micho12345/E4/TP3/TP3_E4_G1.pdf

# TP Nº3 - ELECTRONICA IV: ´ Convertidor Trifasico ´

Bustelo, Nicolas´
61431

Venier Anache, Valentino
60097

Dalla Lasta, Pedro
59502

Resumen—El objetivo de este informe es el analisis del inverter ´ y la importancia de su proceso de diseno. ˜
Index Terms—Power Electronics, Circuit Analysis, Inverter, Switching Circuit, PWM Control, Inverter Testing and Measu-rement.
I. INTRODUCCION´
En este informe se detalla el diseno, implementaci ˜ | on y ´
analisis de un convertidor Inverter, detallado de forma ideal ´ en la Figura 1 con las siguientes caracter´ısticas:
mf | ma | F | MOS | Integrado
≤33 | ≤ 1.3 | 50Hz | IPD50R650CEAUMA1 | UCC27710DR

Se considera a la tension´ Vd como la tension rectificada de ´ la tension de l ´ ´ınea en Argentina (≈ 310V ± 20 %).

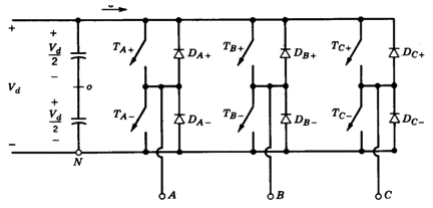
[picture p1: figure]

Figura 1: Inverter ideal generico. ´

II. DISENO˜

II-A. Simulacion´
Para hallar los mejores parametros para la modulaci ´ | on del ´
inverter, se recurrio a la plataforma de Matlab, utilizando la ´ biblioteca Simscape para armar mediante bloques en Simulink el modelo ideal propuesto en el Mohan, con ma = 0,8 y mf = 15.
Luego de corroborar el correcto funcionamiento utilizando una carga de R = 20Ω, L = 1mH identica para evitar el ´
desbalanceo, se procedio a investigar los valores ´ | optimos para ´
lograr la salida buscada. Buscando que la amplitud de la salida
pueda regularse de manera lineal, se opto por mantener ´ | ma
en 0.8 para operar en dicha zona (ma ≤ 1). Para eliminar la
mayor cantidad de armonicos posibles, ´ | mf deb´ıa ser impar
y multiplo de 3, por lo que finalmente se decidi ´ | o utilizar ´
mf = 33. Esto se puede explicar puesto que para valores muy grandes de mf , subarmonicos en cero y cercanos a cero pese a ´ su baja amplitud resultan en grandes corrientes que ser´ıan poco
deseables, y a valores pequenos para eliminar a los arm ˜ | onicos ´
pares mf debe ser impar. En adicion, si ´ | mf es multiplo de 3 ´
entonces los armonicos m ´ | as dominantes de la tensi ´ | on l ´ | ´ınea-a-
l´ınea se cancelan. Tambien se reduce la vibraci ´ | on en el motor, ´
as´ı como el calentamiento del mismo.

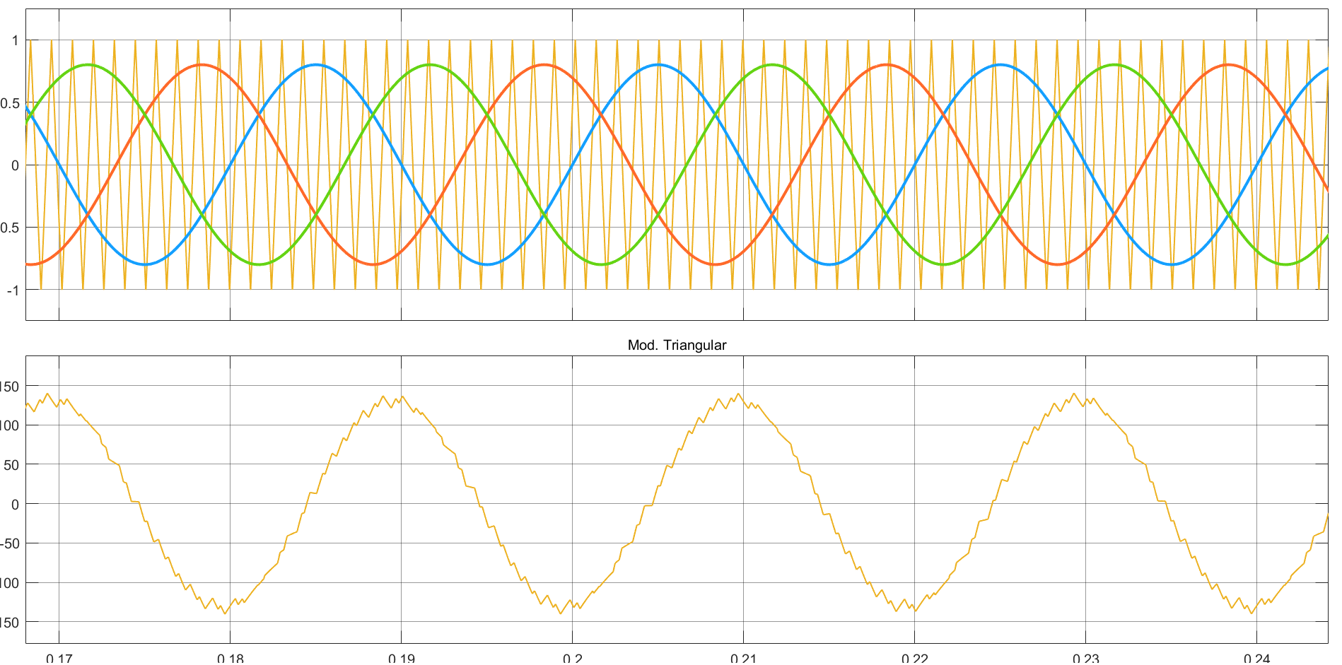
[picture p2: figure]

Figura 2: Salida de la simulacion, contrastada con las se ´ | nales ˜
del PWM

La tension l ´ ´ınea-a-l´ınea, anteriormente mencionado, puede describirse como:

VLL =

√
3
√
2
VˆAN = 0,612maVd = 152,327Vrms | (1)
En la simulacion puede apreciarse que ´ | VLL alcanza valores
cercanos a 138,8Vrms, lo cual es entendible puesto que la carga empleada al simular no es ideal. No obstante, como se observara m´ as adelante, los resultados arrojados son bastante ´ cercanos a lo visto al medir la placa.
Si se aumenta el valor de ma a un valor muy grande (por ejemplo 100) se podr´ıa apreciar otro tipo de modulacion: la ´
modulacion de onda cuadrada. En la misma cada switch est ´ | a´
prendido durante 180o
(un Duty del 50 %) por lo tanto, en cualquier instante, siempre hay tres llaves encendidas. En este tipo de modulacion, el ´ inverter no puede controlar la amplitud de la salida de la tension´ AC, por lo que se requiere que se
controle la tension de entrada ´ | Vd para controlar la misma.
Consecuentemente, la tension l ´ | ´ınea-a-l´ınea ahora se describe
como:

VLL =

√
√
2

π

Vd
2
= 0,78Vd = 242,679Vrms | (2)
Mientras que en la simulacion la tensi ´ | on resultante es ´
229,45Vrms. Si comparamos ambas salidas una junto a la
otra se puede ver como la modulaci ´ | on cuadrada tiene mayor ´
amplitud, a coste de una distorsion arm ´ | onica mucho mayor: ´

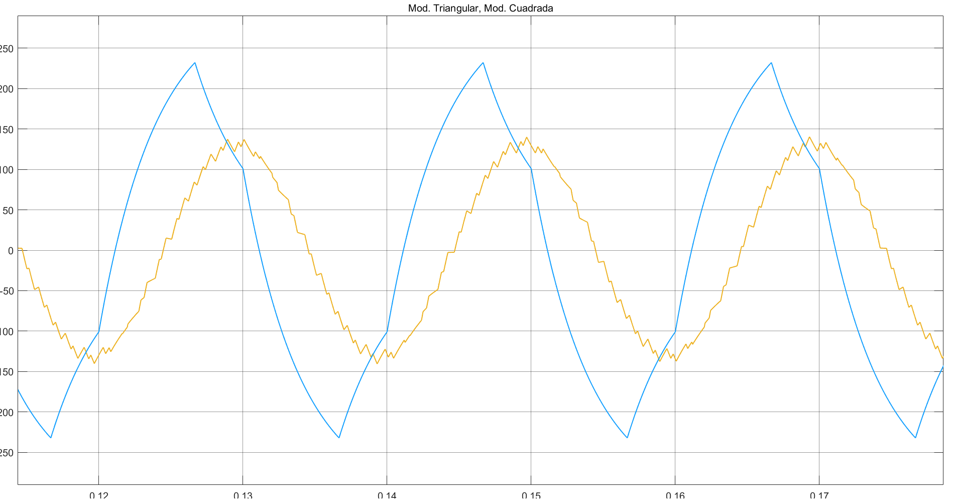
[picture p3: figure]

Figura 3: Comparacion entre ambos m ´ | etodos de modulaci ´ | on´

III. CONTROL DE DISPARO
El sistema de control de disparo de las ramas se basa
en la implementacion de una placa ´ | UPDuino v3.0 la cual
contiene un modulo ´ | FPGA.
La programacion se basa en tres m ´ | odulos principales de los ´
cuales se interconectan para lograr seis salidas.
El primer modulo ´ | TriangularWaves se encarga de generar
una senal triangular la cu ˜ | al tiene amplitud y frecuencia confi- ´
gurables ya que una de las funciones que debe poderse hacer
es cambiar los ´ındices de modulacion, tanto ´ | mf como ma.
Este bloque se basa en un contador de 12 bits signados que cuando llega a su maximo valor se decrementa y cuando llega ´ a su m´ınimo valor se incrementa. De esta forma y con un divisor de clock a la mitad del valor real (12MHz) se genera
una senal triangular de frecuencia ˜ | 1490Hz.
El segundo modulo ´ | ModulatingWaves es el mas importante ´
de los tres. Su funcion principal se basa en buscar datos en ´ una LUT establecida en memoria SRAM con funcionamiento de 1MHz. Son tres los punteros que recorren la tabla indicando
la posicion de cada valor correspondiente a las tres se ´ | nales ˜
de un sistema trifasico, es decir, cada puntero se encuentra ´ desfasado 120o
en representacion de una se ´ | nal real. ˜
En la LUT se encuentran 10000 muestras de medio ciclo de senoide en donde cada muestra es de 12 bits. Con este muestreo y con el modulo mencionado, se puede recrear una ´ senoidal completa de 20000 muestras ya que si se recorre la tabla de forma inversa y con el valor de la tabla negado, se obtiene el medio ciclo faltante. El primer puntero comienza en la posicion´ 0 con el valor de la tabla contando en forma ascendente, el segundo puntero comienza en la posicion´ 6666 con el valor de la tabla contando en forma ascendente, y el tercer puntero comienza con el valor de la tabla negado contando en forma descendente. Aqu´ı se obtienen los valores iniciales de tres senoides desfasadas 120o

Como no se pueden rescatar tres valores a la vez en un mismo ciclo de clock, se utiliza una maquina de estados en ´ la cual busca los valores de a uno para luego en el doceavo ´ ciclo ponerlo en la salida. Esto se puede hacer ya que como la salida cambia cada 1µs y el clock interno trabaja en menos tiempo, se utiliza ese tiempo para poder rescatar los datos. El tercer modulo ´ Comparator es simplemente un compa-rador que observa dos valores de 12 bits y dependiendo cual´ sea el valor, en la salida habra un ´ 1 o un 0. Si la entrada proveniente de la senoidal generada es mayor que la senal de ˜ la triangular, la salida sera un ´ 1, caso opuesto la salida sera´ 0. Como esta es la salida final de uno de los MOS de una rama,
este modulo tambi ´ | en tiene una salida extra que es exactamente ´
la opuesta a la salida original. Dado con esto incluido, ya
se obtienen las dos senales para una rama, una para el ˜ | MOS
superior y otra para el MOS inferior. Por lo tanto, habra tres ´ comparadores en total, lo cual generan las seis salidas para las ´ tres ramas correspondientes.
Una vez obtenidos los tres bloques, se designaron los pines de salida y se conectaron al PCB del inverter.

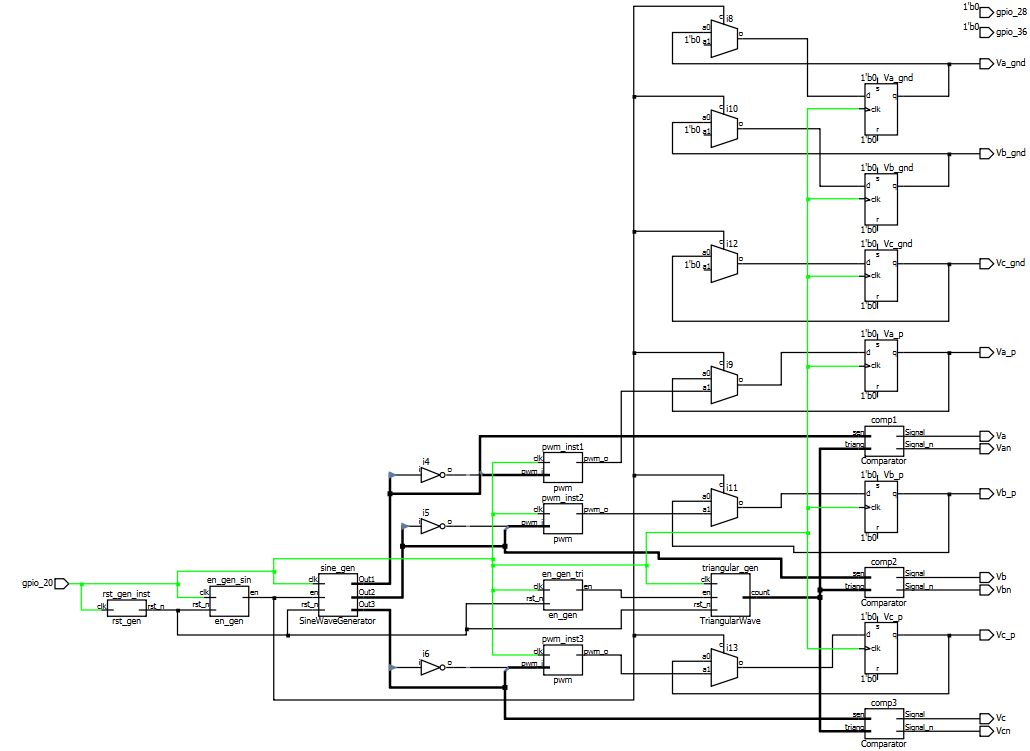
[picture p4: figure]

Figura 4: NetList de Programacion. ´

IV. IMPLEMENTACION´

IV-A. PCB
Concluidos el analisis te ´ | orico y las simulaciones, se proce- ´
dio a fabricar el ´ | PCB. En la Figura 16 del anexo se puede ver
el esquematico utilizado. ´

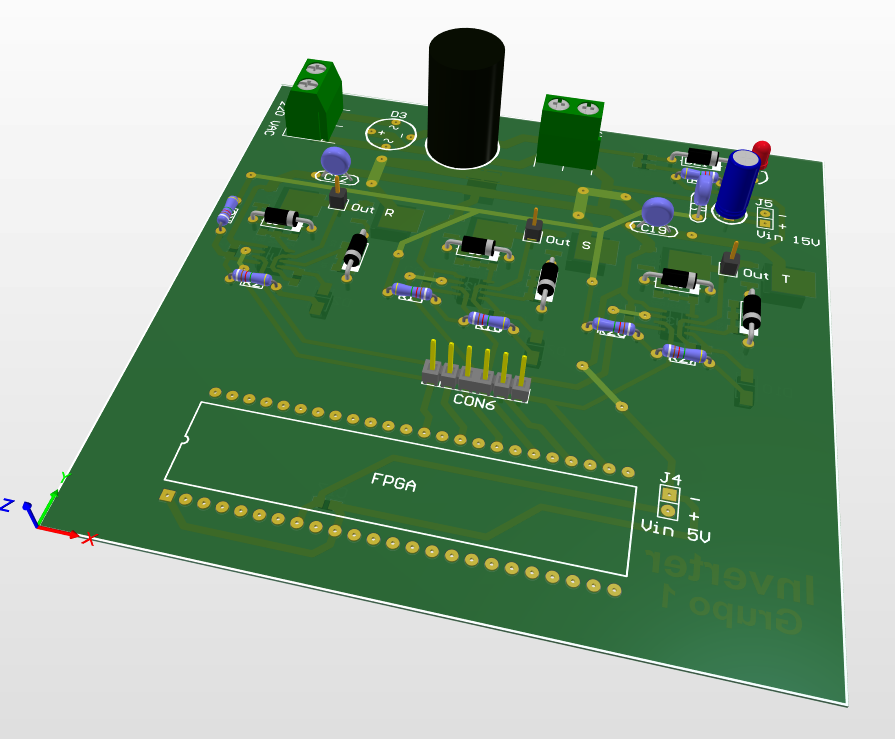
[picture p5: figure]

Figura 5: Modelo PCB en Altium.

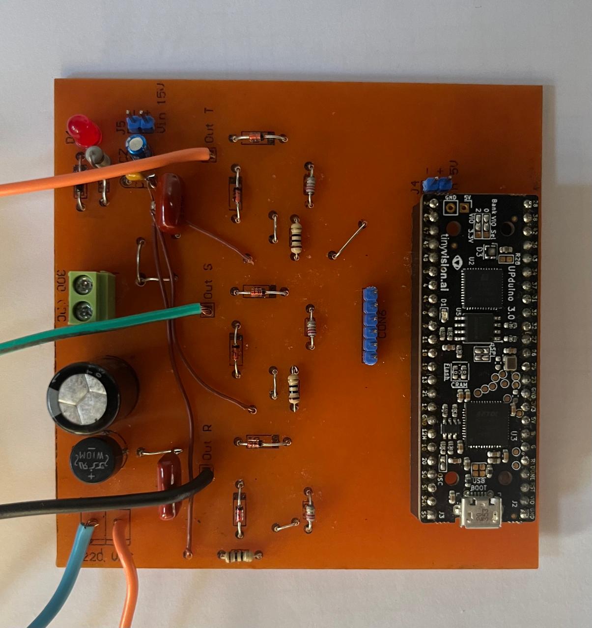
[picture p6: figure]

Figura 6: Placa vista superior.

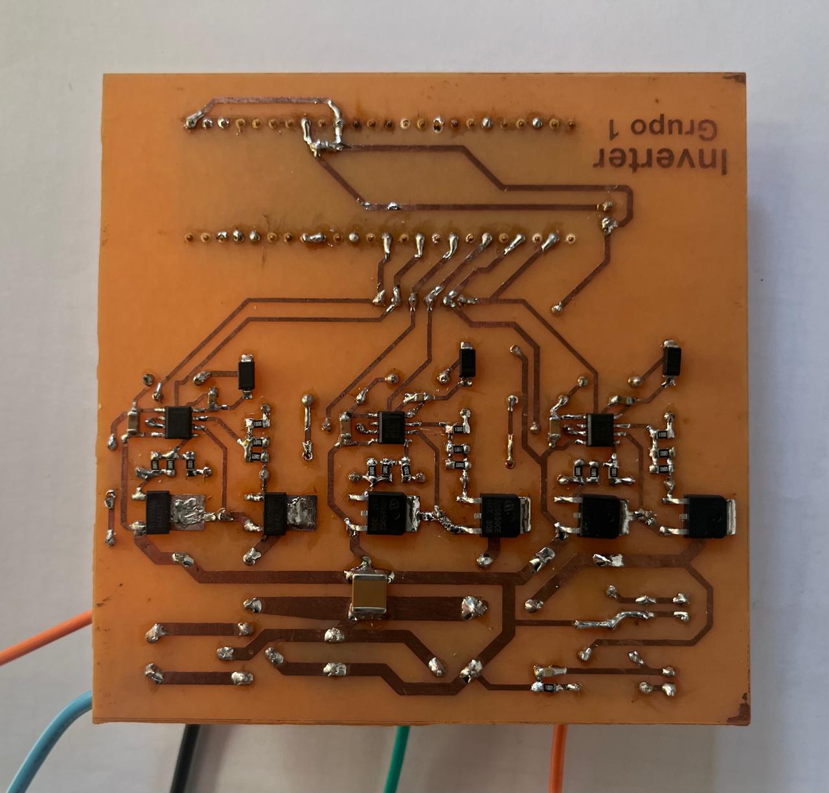
[picture p7: figure]

Figura 7: Placa vista inferior.

Para el analisis del ´ | layout, se tuvieron en cuenta los lazos
de corriente que existen en el apagado y el encendido del
transistor. Por esta razon, la configuraci ´ | on de los componentes ´
y de las pistas se tuvo que disenar detalladamente para prevenir ˜ corrientes inducidas no deseadas, evitando lazos de corrientes englobados. Tras numerosas iteraciones se logro obtener el layout deseado que se puede observar en la siguiente figura:

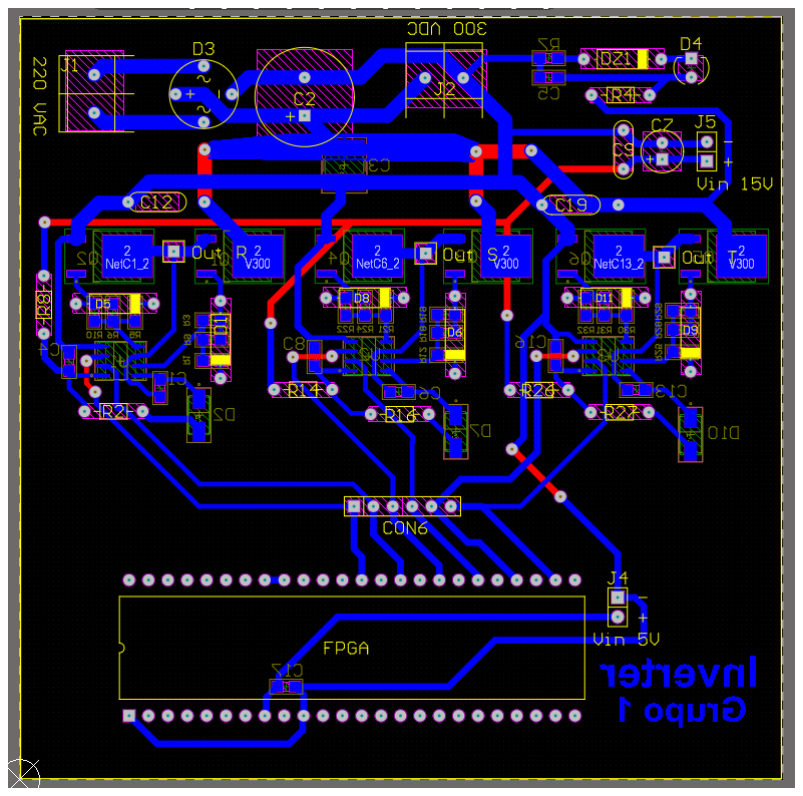
[picture p8: figure]

Figura 8: Layout del PCB

IV-B. Metodo de puesta en marcha ´
Para probar el circuito, se conecto la entrada del circuito ´ a un variac apagado y con salida m´ınima. Este a su vez esta´ conectado a un transformador de aislacion´ 1 : 1, que se conecta directamente a la red electrica. De este modo el circuito queda ´ aislado y es seguro realizar mediciones sobre el circuito. Luego de estar los cables y conectores seguramente colo-cados, se coloca una punta en modo x10 en el gate y en el draing del MOS. Si en algun punto presenta signos de falla se ´ apaga el variac y se comprueba nuevamente el circuito.
V. MEDICIONES
Una vez armado el circuito, se procedio a realizar las ´ mediciones correspondientes. Antes de medir se aislo el os- ´ ciloscopio con otro transformador de aislacion´ 1 : 1 por seguridad.

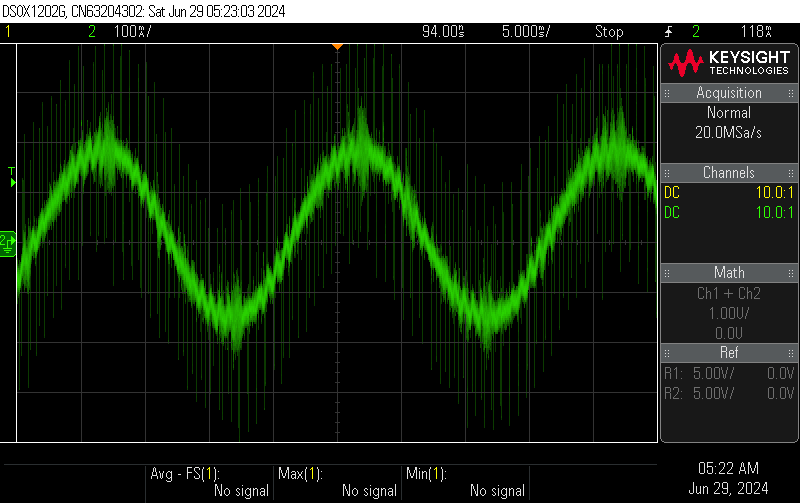
[picture p9: figure]

Figura 9: Corriente de una fase alimentando al inverter con 50VAC.

La corriente de fase es exactamente como se esperaba, con
el ruido de conmutacion reflej ´ | andose alrededor de la onda ´
senoidal.

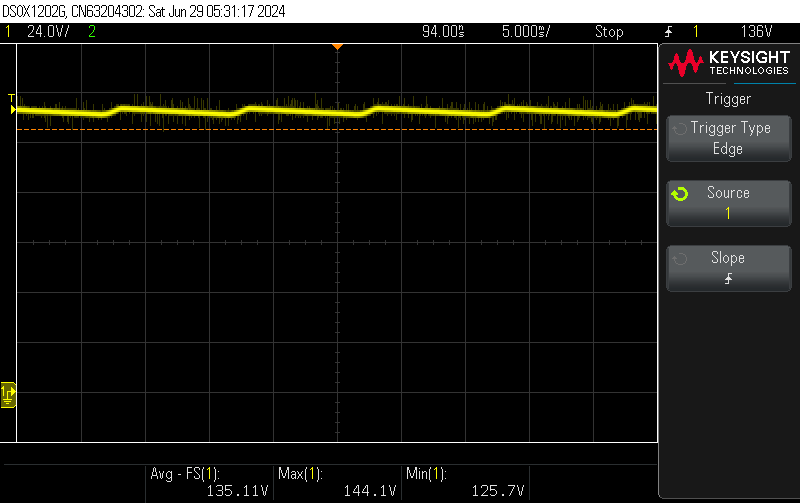
[picture p10: figure]

Figura 10: Vdrain con 100VAC

En la tension del Drain se puede apreciar un ´ | ripple del
6, 8 %, es aceptable considerando la magnitud de Vdrain

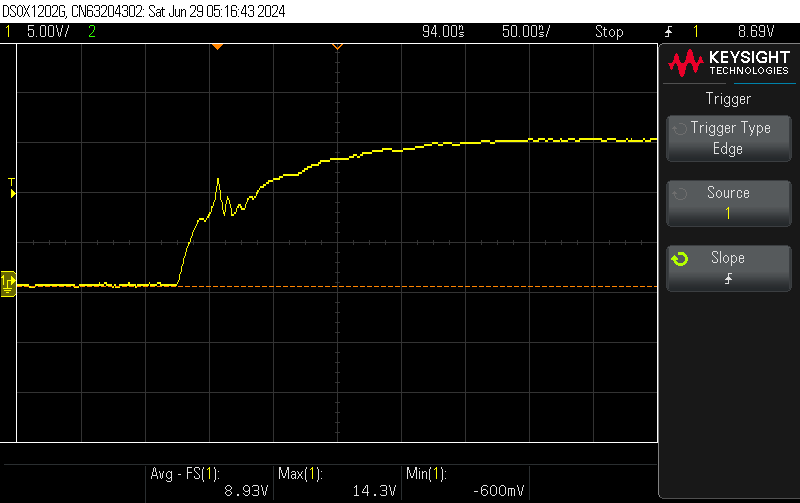
[picture p11: figure]

Figura 11: Vgate Q1 ON

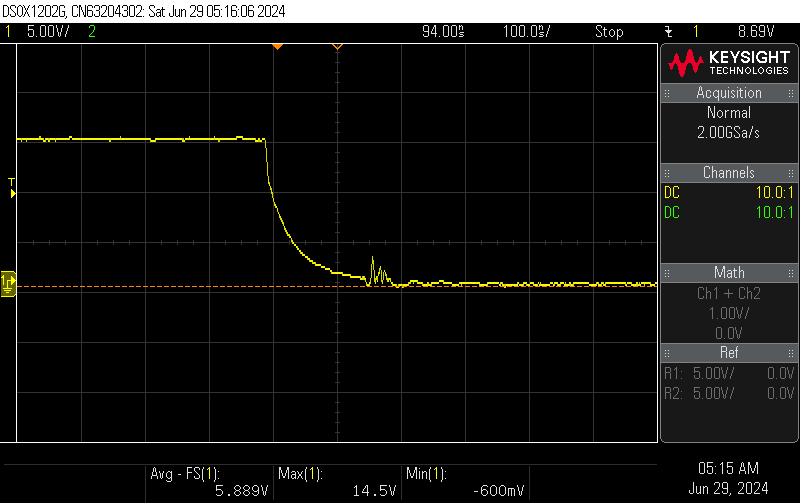
[picture p12: figure]

Figura 12: Vgate Q1 OFF

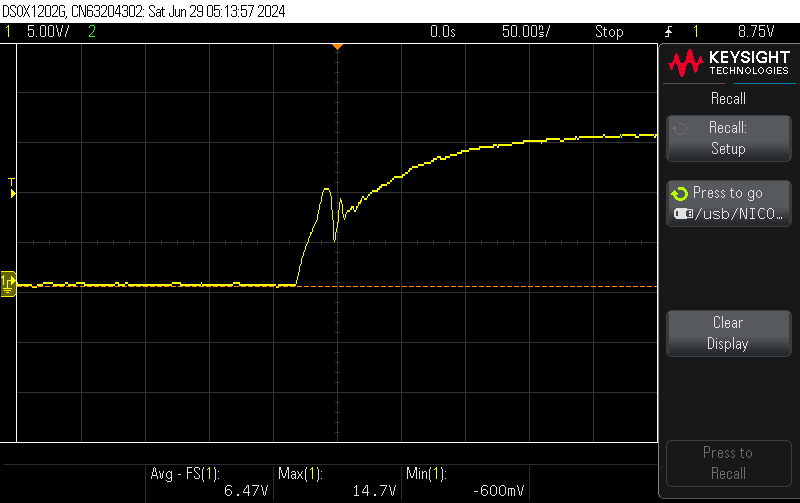
[picture p13: figure]

Figura 13: Vgate Q2 ON

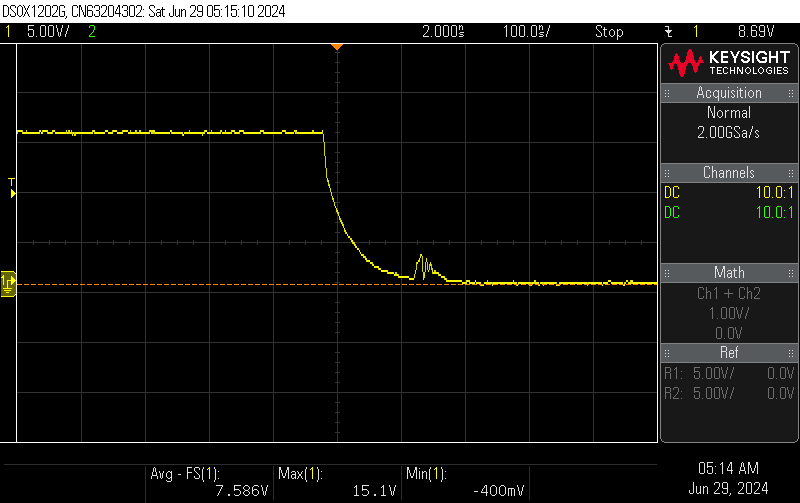
[picture p14: figure]

Figura 14: Vgate Q2 OFF

Tanto en la Figura 11 como en la Figura 13 se ve que luego del sobrepico disminuye la tension. Esto es el transistor ´ intentando apagarse. Pese a ello no es un impedimento para el funcionamiento del circuito.
El efecto opuesto ocurre en la Figura 12 y la Figura 14, con iguales resultados.
Una observacion que cabe se ´ | nalar fue que, durante las ˜
complicaciones que aparecieron en las mediciones, en ningun´
momento se quemaron los driver, por mas que los ´ | MOS s´ı
lo hicieran y quedara Vgs en corto estos componentes se mantuvieron intactos. Se los recomienda emplear para el disparo de los transistores.

VI. CONCLUSION´

A traves de un enfoque met ´ | odico de iteraci ´ | on y detallado, se ´
logro dise ´ | nar, construir y probar un convertidor tipo ˜ | Inverter
trifasico ´ | , cumpliendo con los objetivos establecidos.
| REFERENCIAS
[1] William P. Robbins, Tore M. Undeland, Ned Mohan “Electronica de ´
Potencia: Convertidores, Aplicaciones Y Diseno”3ra. edici ˜ | on, 2009. ´

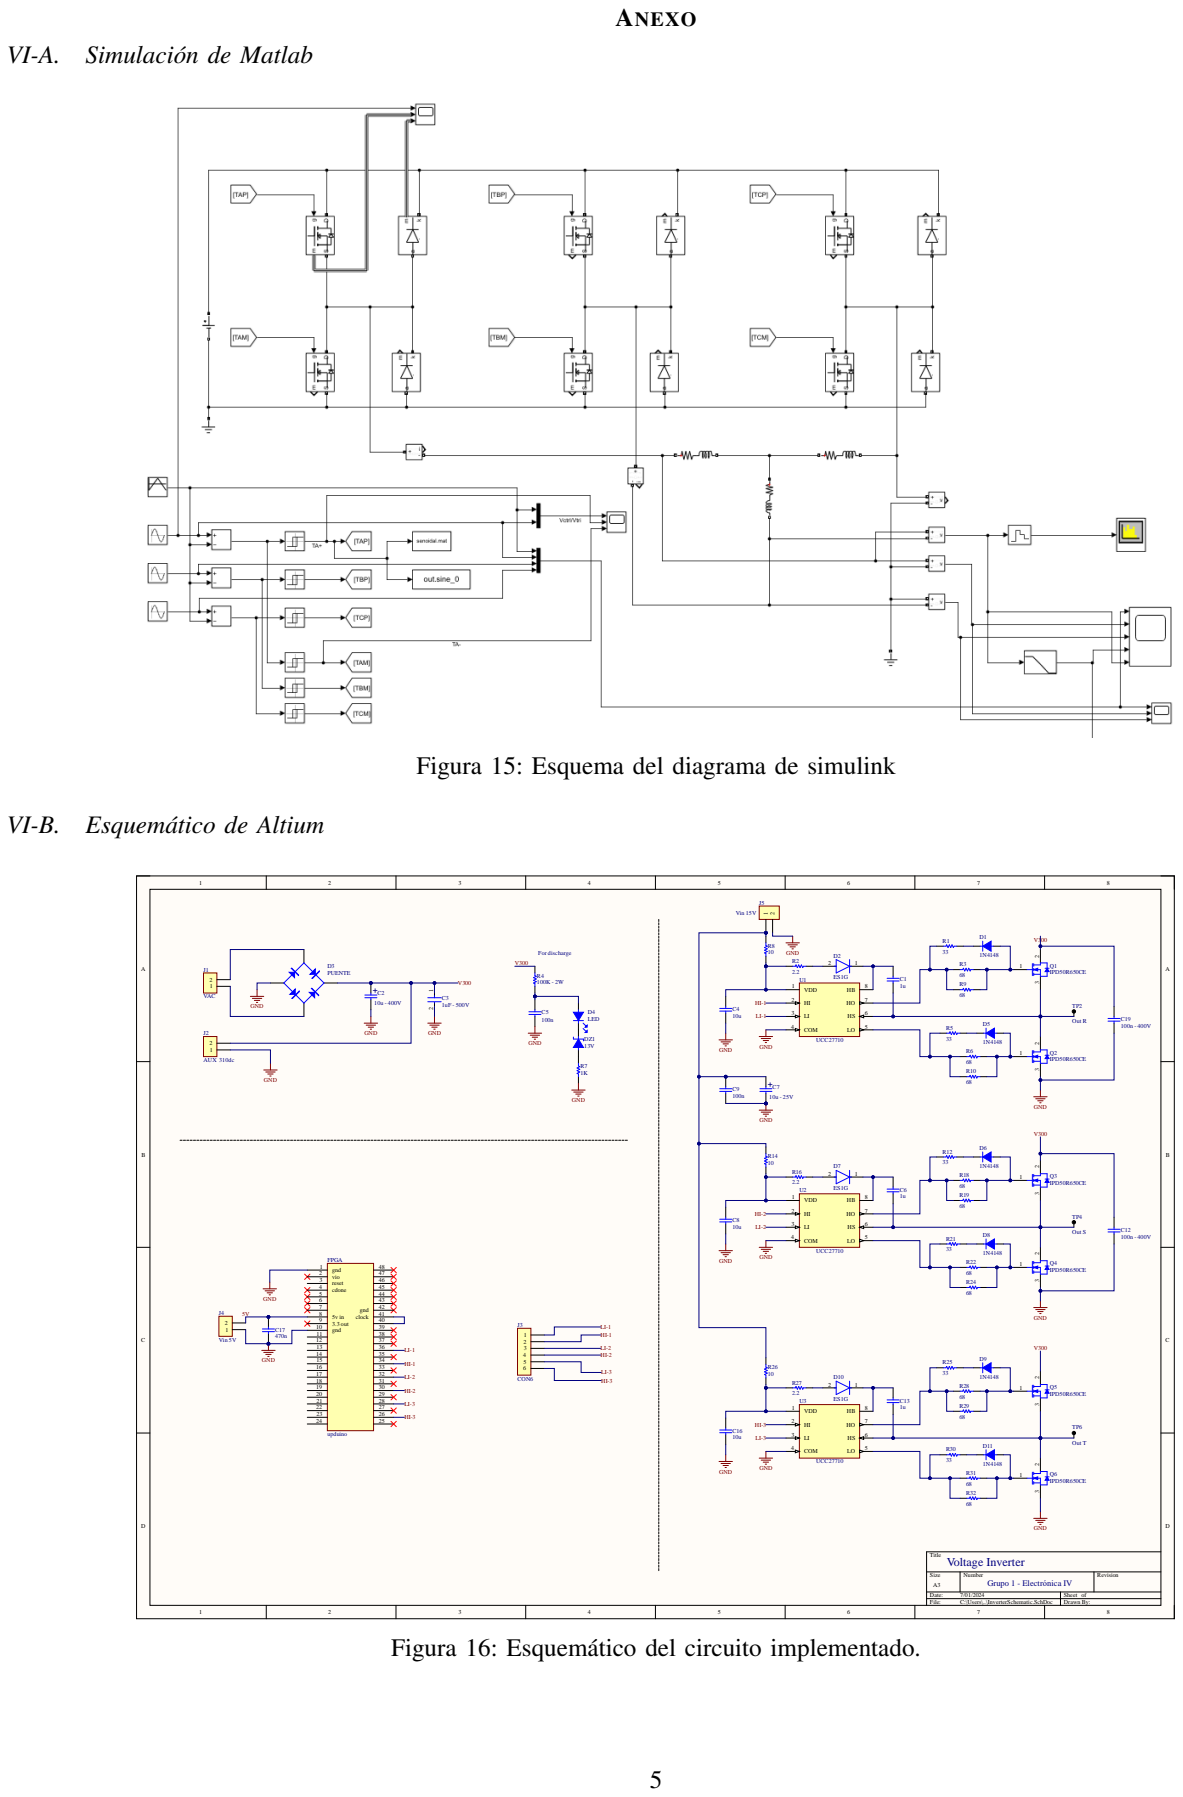
[picture p15: page 5]

VI-A. Simulacion de Matlab ´

Figura 15: Esquema del diagrama de simulink

VI-B. Esquematico de Altium ´

Figura 16: Esquematico del circuito implementado. ´
