micho12345/E4/TP3/Altium/Inverter/Project Outputs for Inverter/BOM/Bill of Materials.PDF

Comment | Quantity | Designator | Footprint | LibRef | Description
1u | 3 | C1, C6, C13 | 0805 | CAP
10u- 400V | 1 | C2 | CAP200RP2 | CAPPOL
1uF- 500V | 1 | C3 | FP-GRM55D-0_4-IPC_B | CMP-2000-06370-2 | ChipMultilayer Ceramic Capacitors for General Purpose, 2220, 1.0uF, X7R, 15%, 10%, 500V
10u | 3 | C4, C8, C16 | 0805 | CAP
100n | 1 | C5 | 0805 | CAP
10u- 25V | 1 | C7 | CAP100RP | CAPPOL
100n | 1 | C9 | CAP200 | CAP
100n- 400V | 2 | C12, C19 | CAP200 | CAP
470n | 1 | C17 | 0805 | CAP
1N4148 | 6 | D1, D5, D6, D8, D9, D11 | DO41 | DIODO
ES1G | 3 | D2, D7, D10 | FP-403AE-MFG | CMP-07163-000025-1 | DIODEGENPURP 400V1ASMA
PUENTE | 1 | D3 | PUENTE- W10M | PUENTE
LED | 1 | D4 | LED3 | LED
13V | 1 | DZ1 | DO41 | DIODOZENER
upduino | 1 | FPGA | FPGA | FPGA | upduinov3.0
VAC | 1 | J1 | BORNERA2 | BORNERA2
AUX310dc | 1 | J2 | BORNERA2 | BORNERA2
CON6 | 1 | J3 | SIP6 | CON6
Vin5V | 1 | J4 | SIP2 | CON2 | UPDuinoPower Input
Vin15V | 1 | J5 | SIP2 | CON2 | UPDuinoPower Input
IPD50R650CE | 6 | Q1, Q2, Q3, Q4, Q5, Q6 | INF-PG-TO252-3-313_N | CMP-1164-00335-1 | N-Channel CoolMOS CEPower-Transistor, 500VVDS, 6.1AID, -55to150degC, PG-TO252-3-313, Reel, Green
33 | 6 | R1, R5, R12, R21, R25, R30 | 0805 | RES | 33?, [NoValue]
2.2 | 3 | R2, R16, R27 | RES300 | RES
68 | 12 | R3, R6, R9, R10, R18, R19, R22, R24, R28, R29, R31, R32 | 0805 | RES
100K- 2W | 1 | R4 | RES300 | RES
1K | 1 | R7 | 0805 | RES
10 | 3 | R8, R14, R26 | RES300 | RES
Out R | 1 | TP2 | TPTH | TP
Out S | 1 | TP4 | TPTH | TP
Out T | 1 | TP6 | TPTH | TP
UCC27710 | 3 | U1, U2, U3 | FP-PG-DSO-8-IPC_C | CMP-32851-000209-1 | GATEDRVRHI/LOW SIDE8SOIC
