micho12345/E4/TP3/Altium/Inverter/Project Outputs for Inverter/Schematic Print/Schematic.PDF

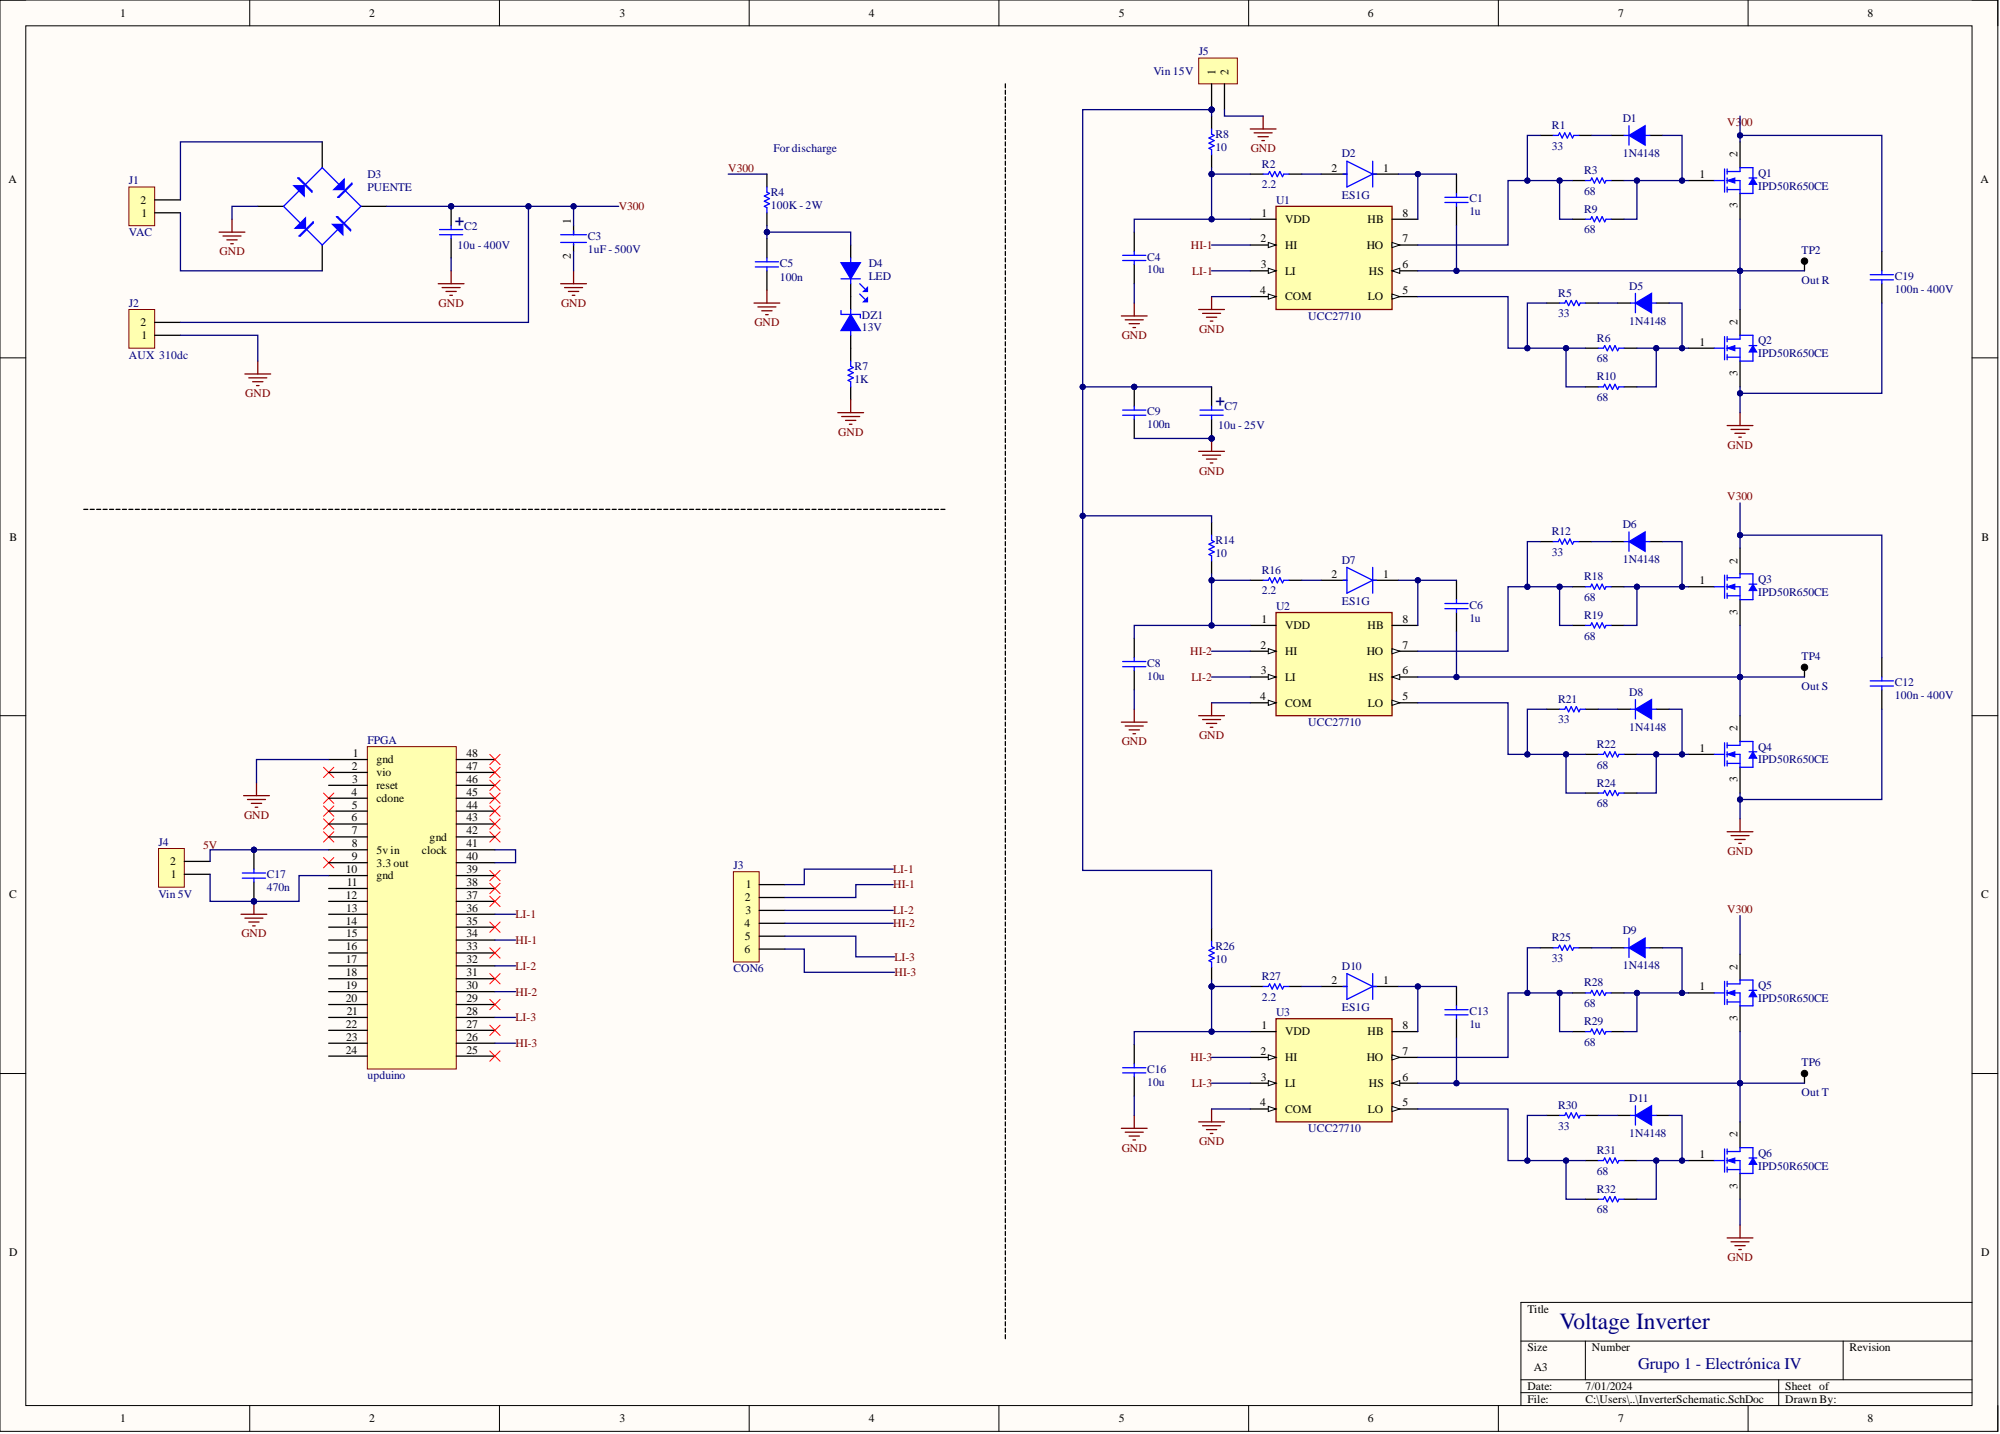
[picture p16: page 1]

Voltage Inverter Grupo 1 - Elect
