micho12345/E4/TP3/Altium/Inverter/Project Outputs for Inverter/PCB Print/Lazos.PDF

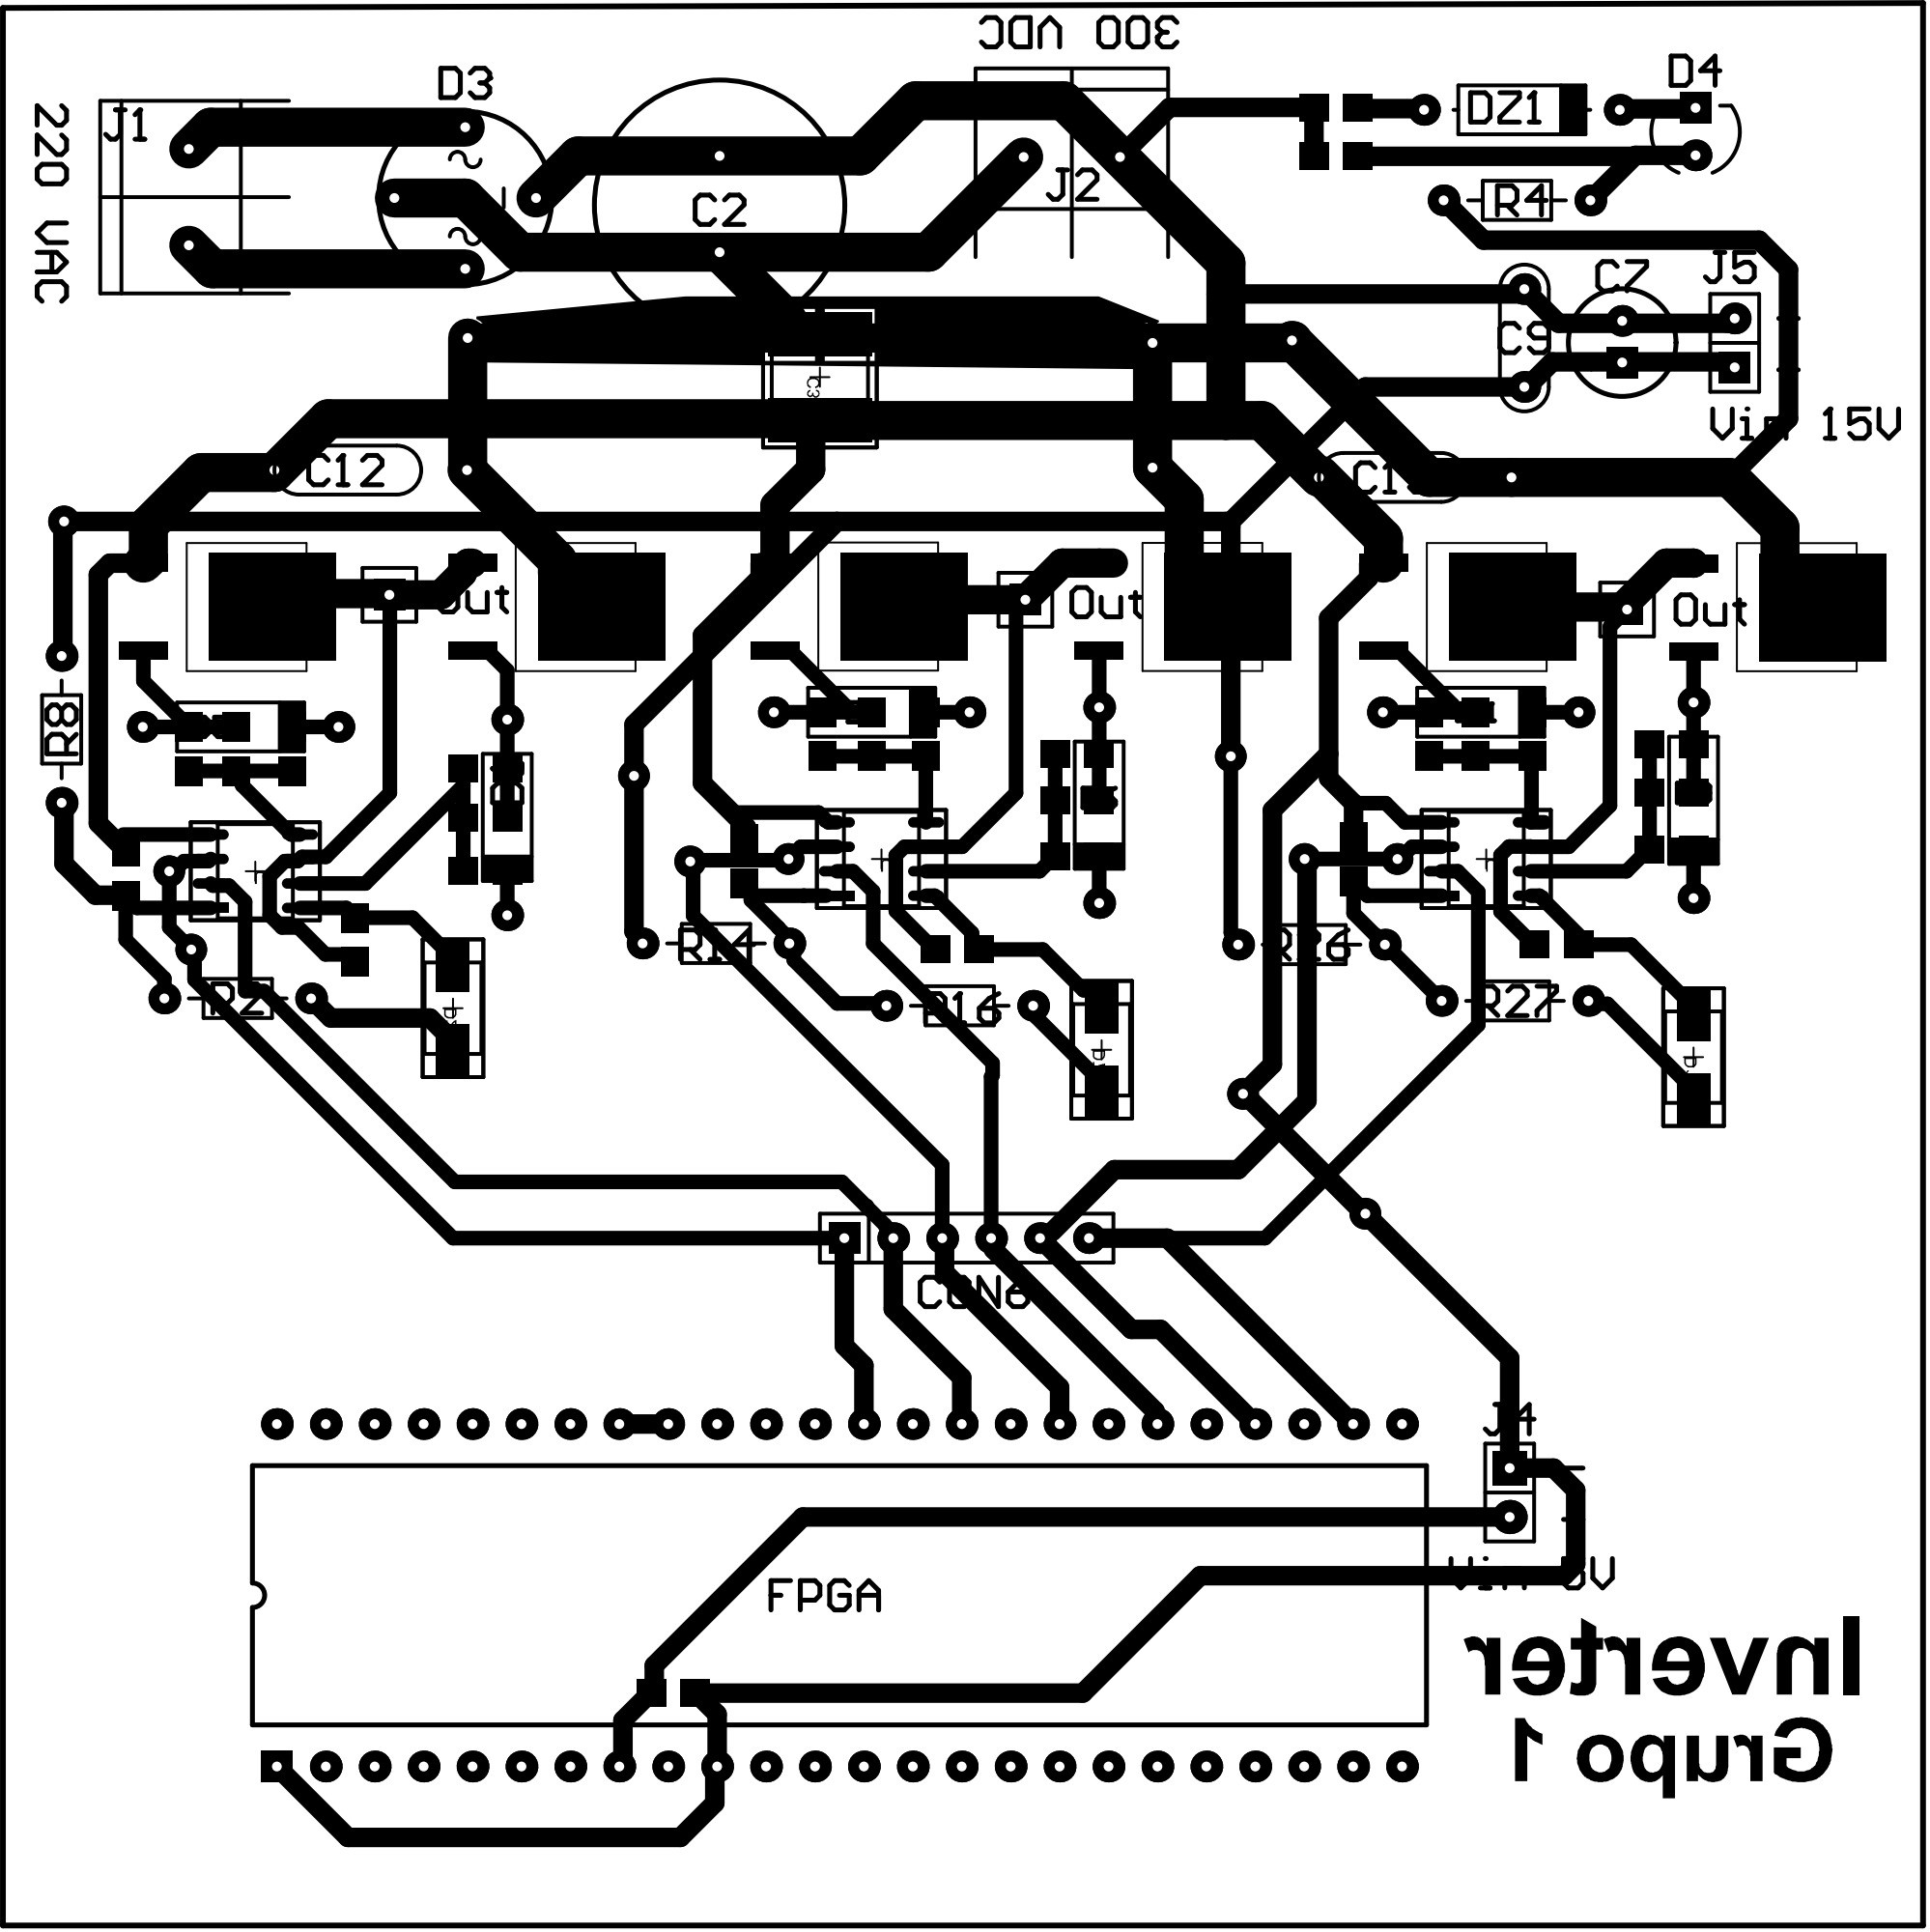
[picture p17: page 1]

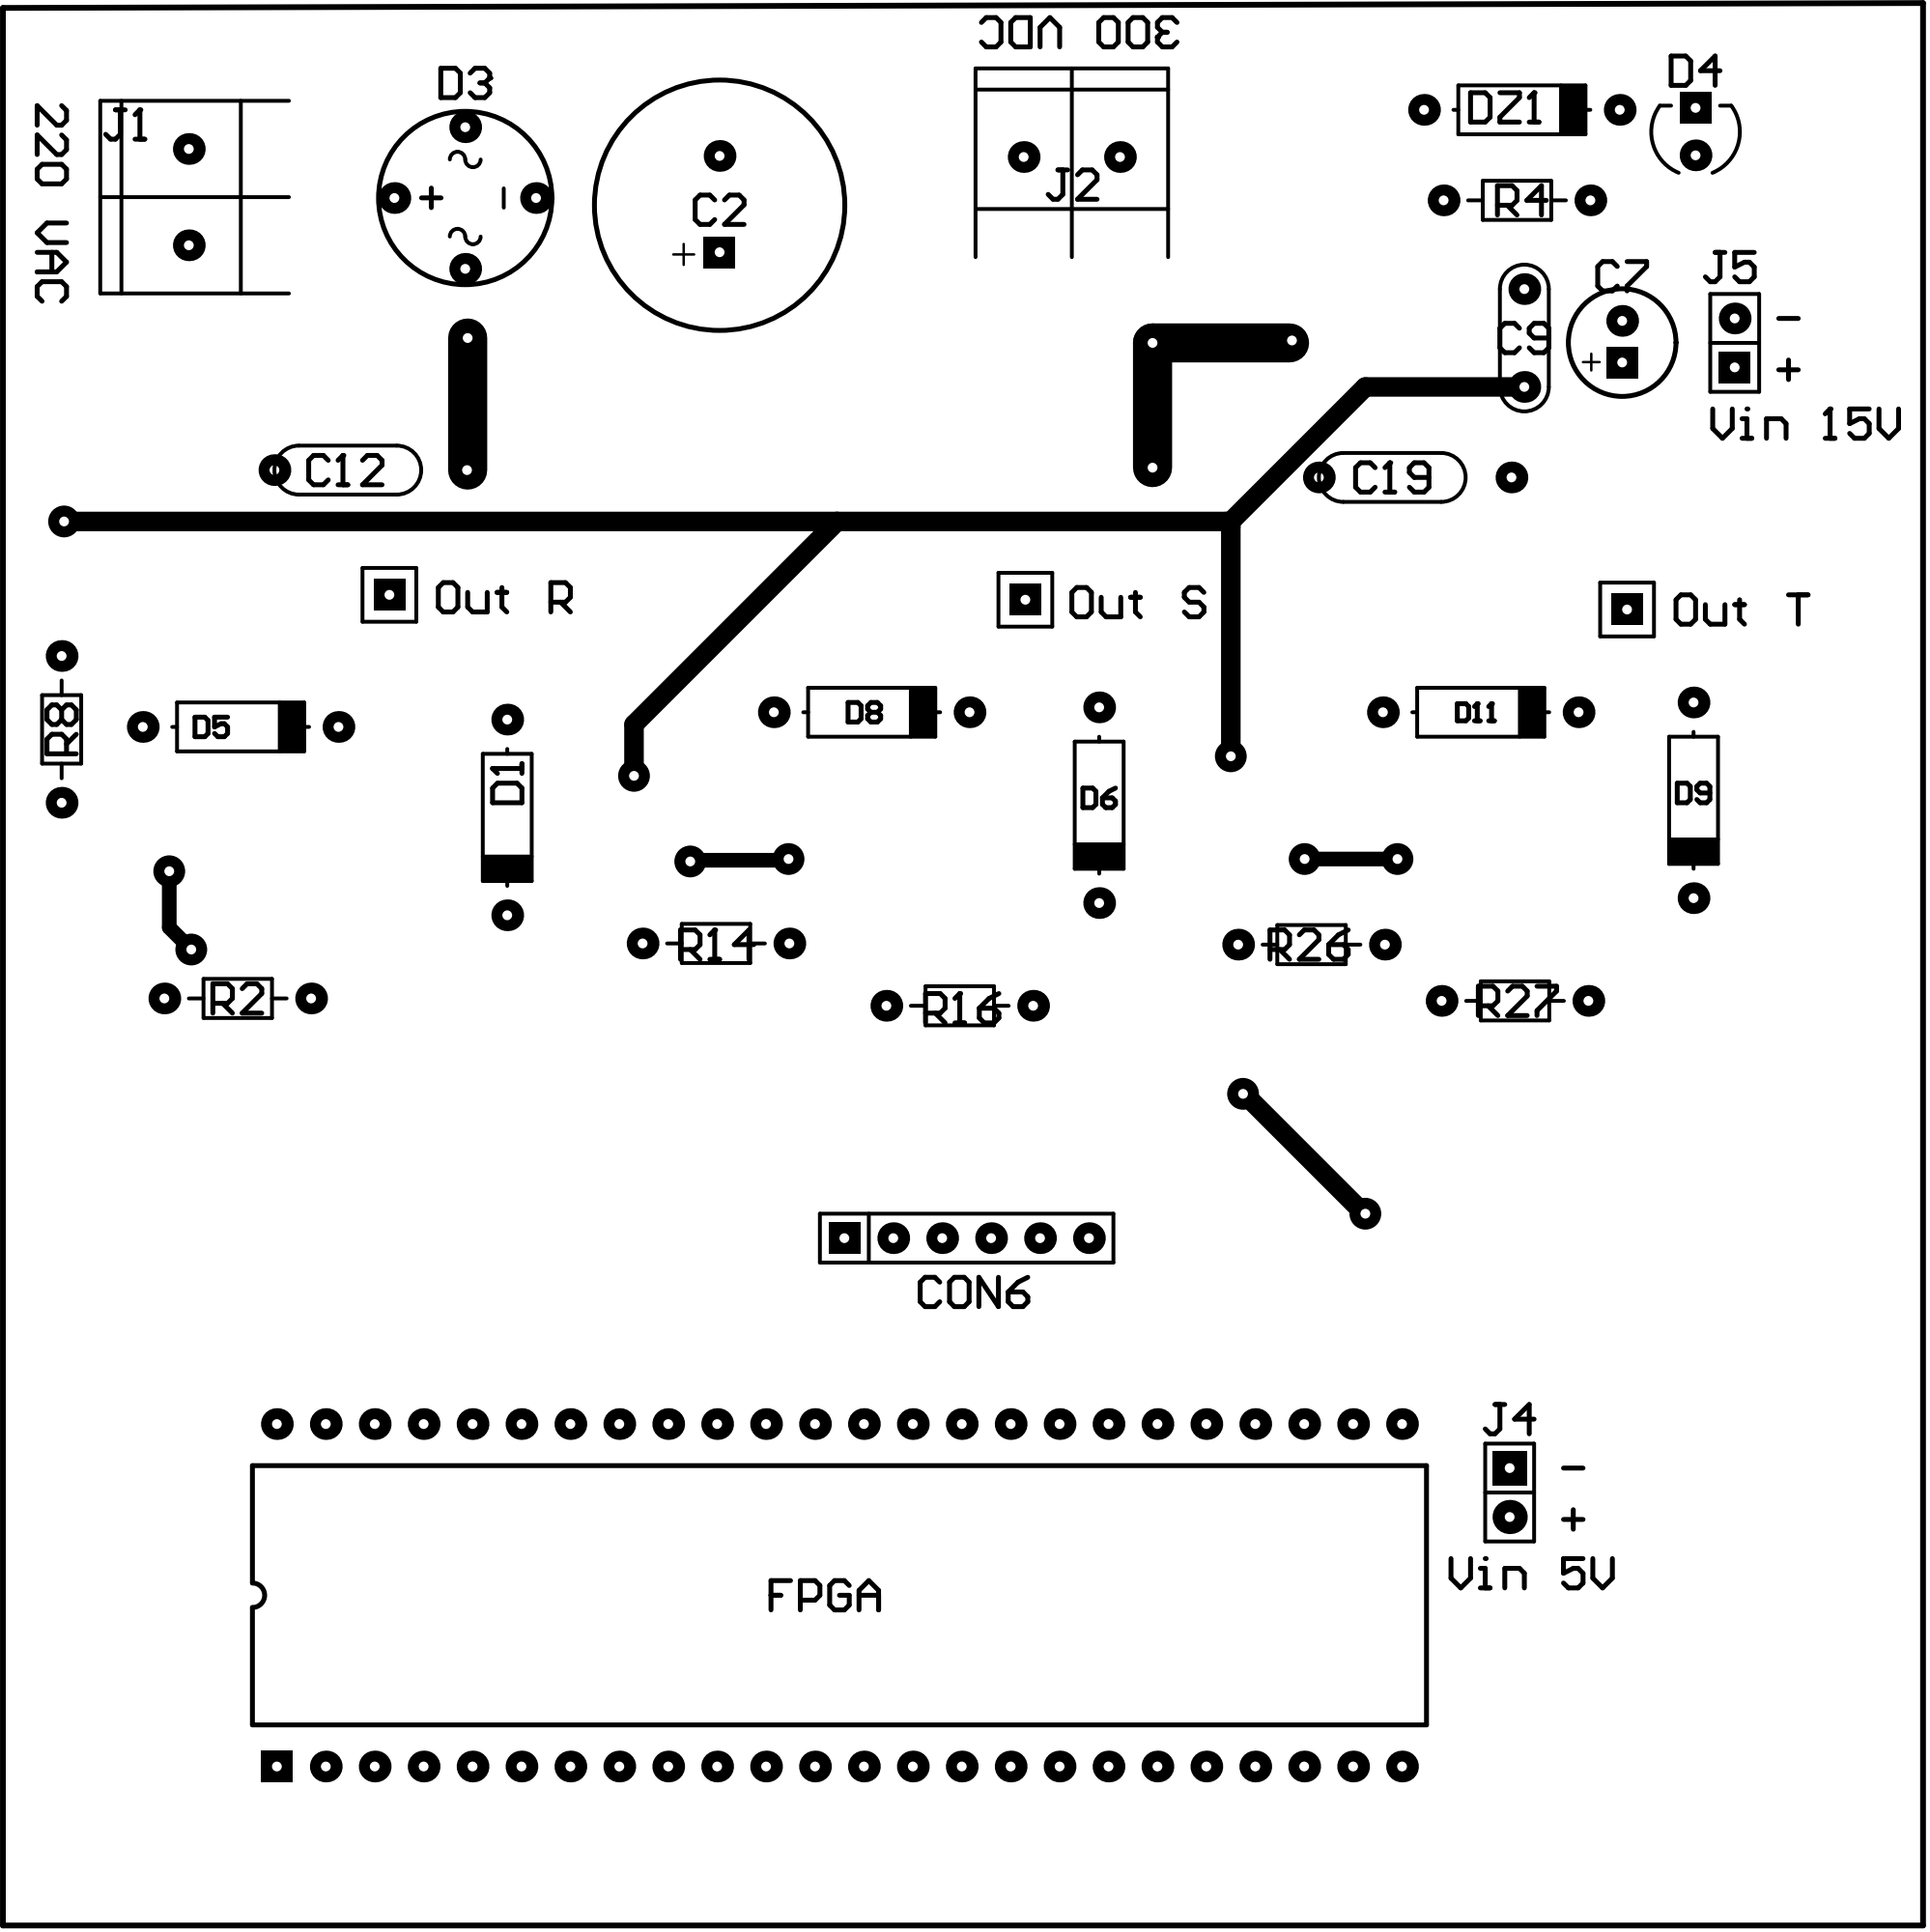
[picture p18: page 2]

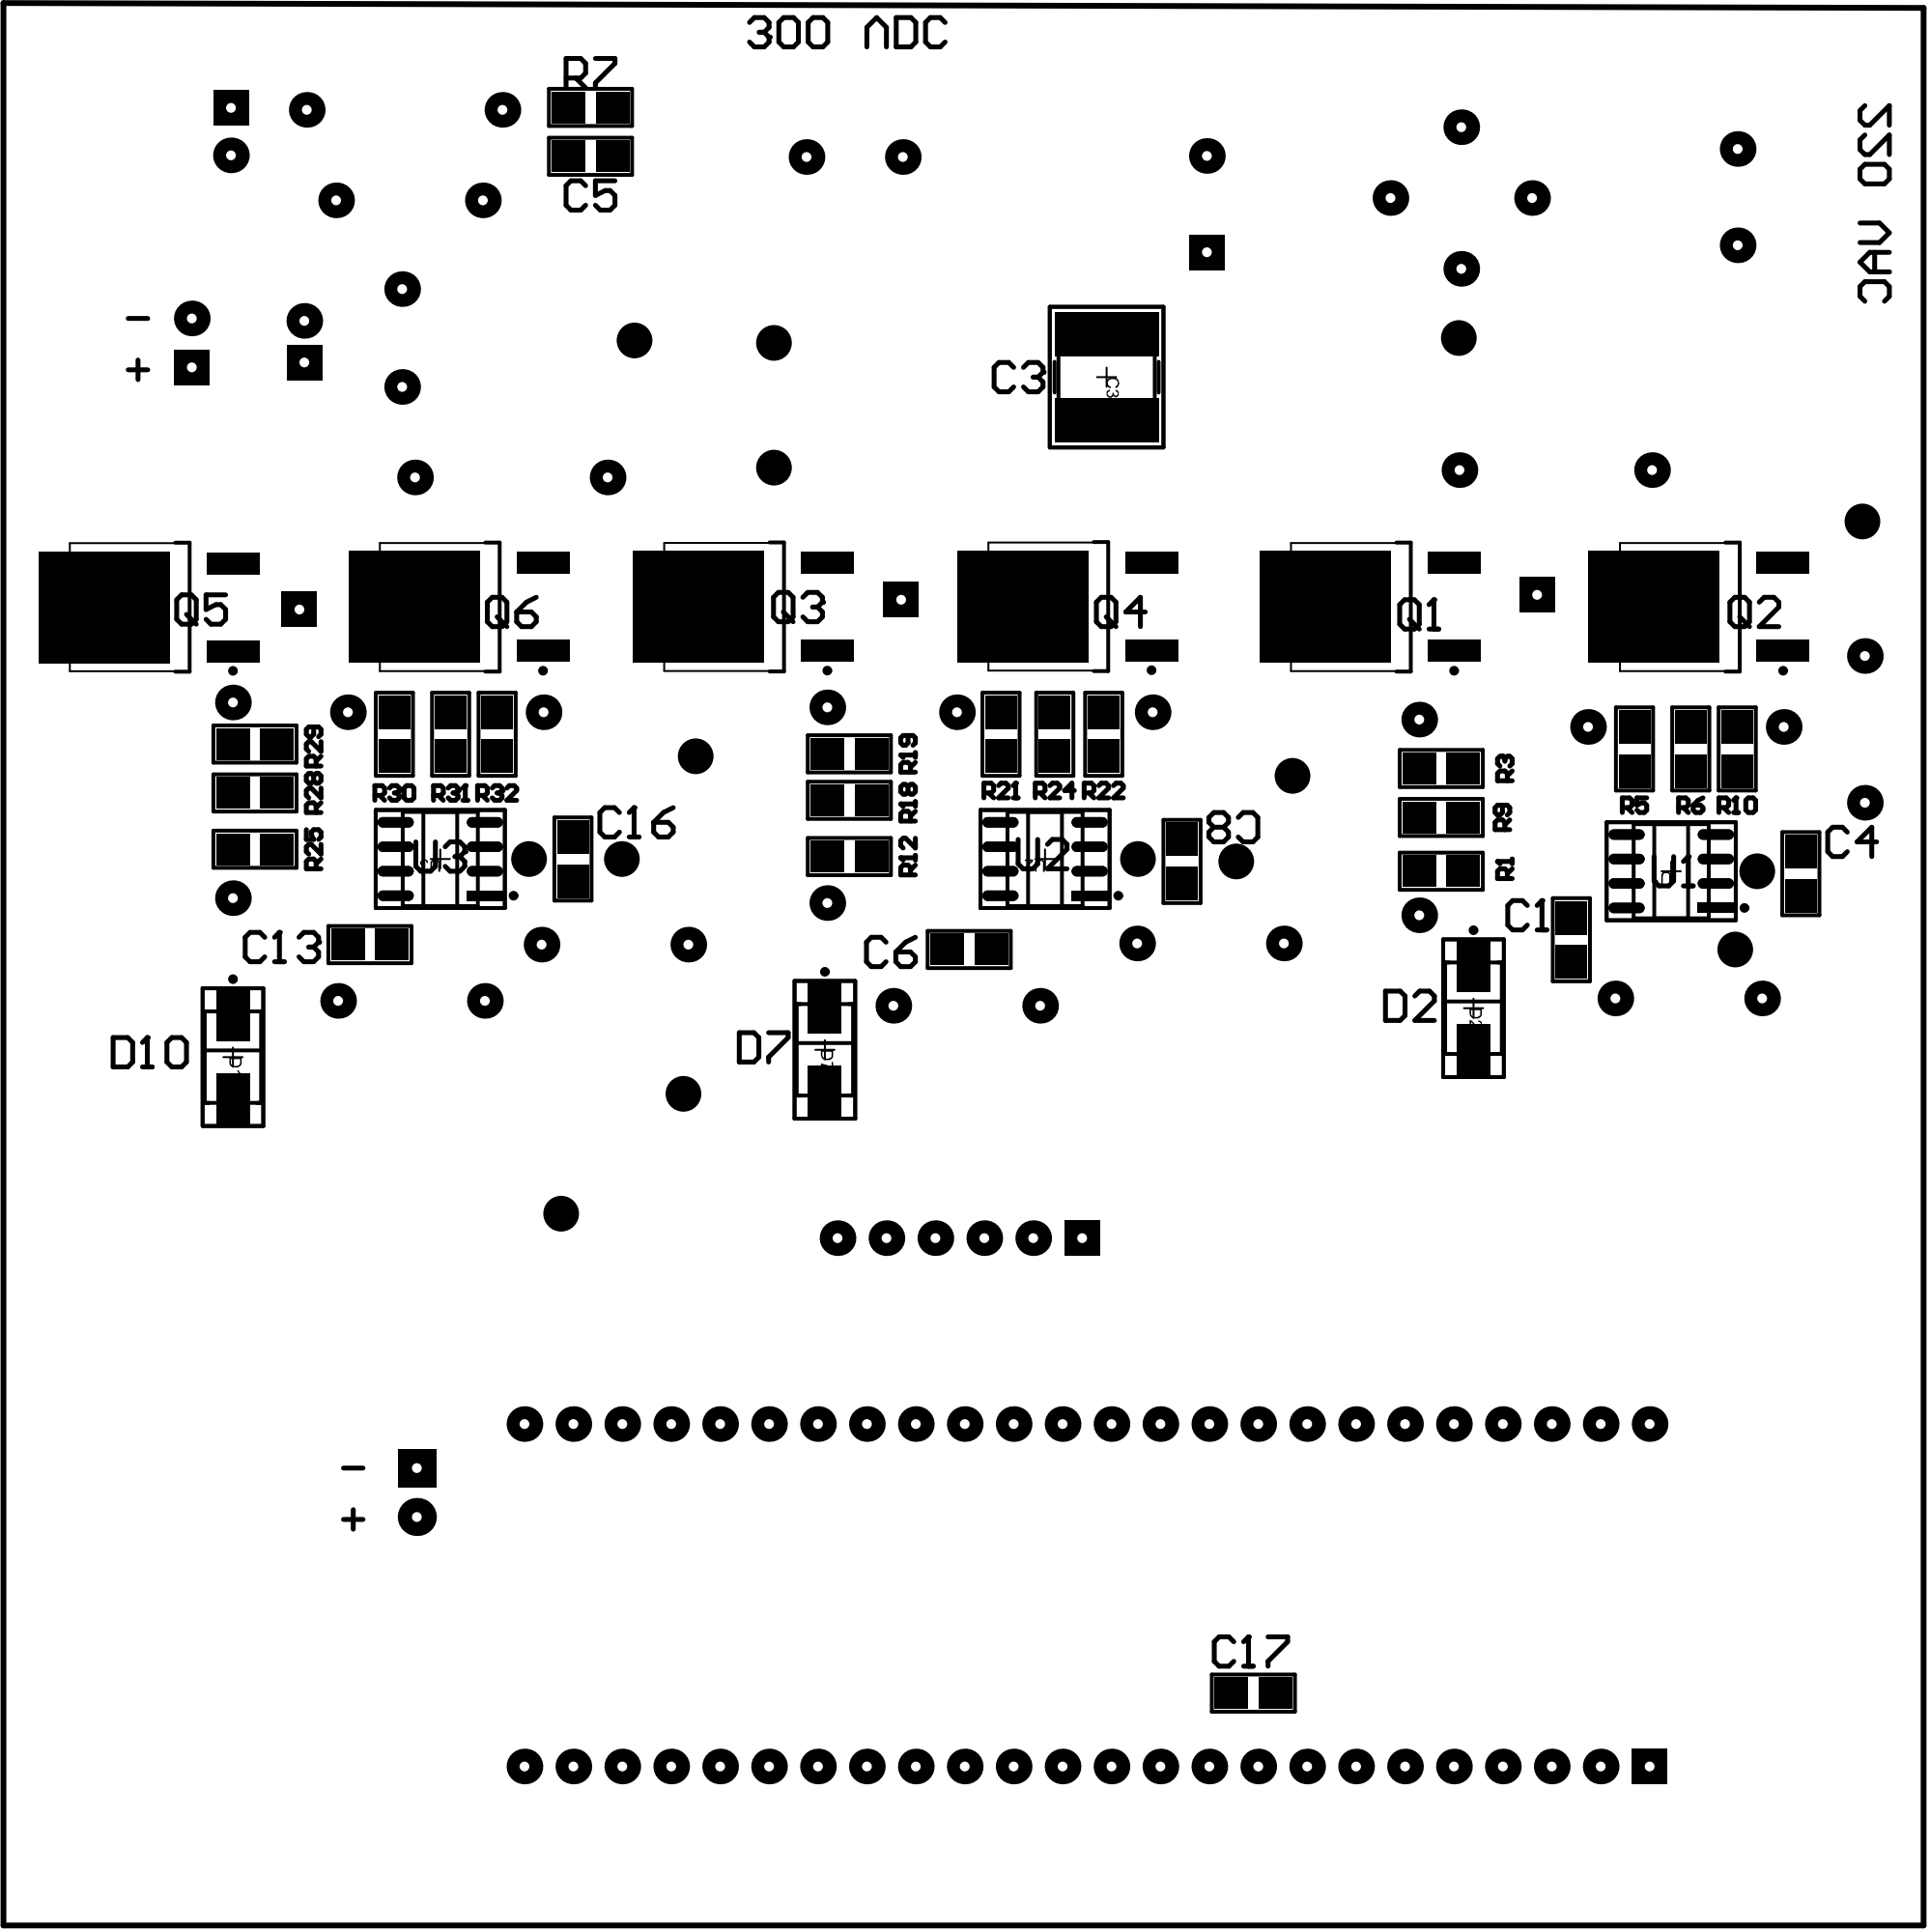
[picture p19: page 3]
