micho12345/E4/(list of files, drawings)

Other design files:
TP3/Altium/Inverter/InverterPCB.PcbDoc
TP3/Altium/Inverter/InverterSchematic.SchDoc
